ealingcommoner/RiverPollutionNetwork/README.md

# RiverPollutionNetwork
Building a low-cost community pollution detector for our local river

*Work in Progress*

## Background to project
The River Brent in West London is a little river which runs through a mix of urban industrial areas and the huge Brent River Park in Hanwell. 
The Brent River in Hanwell

Every few months we see pollution incidents from a range of causes:
- Deliberate dumping of pollutants
- Storm drains
- Badly connected outlets

These cause damage to the wildlife, particularly the many fish and eels which live in the River. 
We have formed a group which keeps an eye on the River and report pollution incidents so the Environment Agency can send a team to investigate and mitigate the damage. 

But we're a small group and it can take hours or days to notice a problem. Local authorities inform us that instaling an industrial monitoring station can be upwards of £6000 and are reluctant to do so on such a small river. So I wanted to know if a community can build something that will do the job for as little money as possible. 

## Aims
Use low-cost, remotely deployed sensors to alert the community to a pollution incident. 

## Measurement
Having reviewed pollution incident reports, it appears the most common indicators are:
- Total Dissolved Oxygen (TDO)
- Total Dissolved Solids (TDS)

TDO sensors are around £130 each, whilst [this TDS sensor](https://www.dfrobot.com/product-1662.html) is £11. We could consider adding TDO in future if funding permits, but for now it seems TDS gives us the best effect for our money.

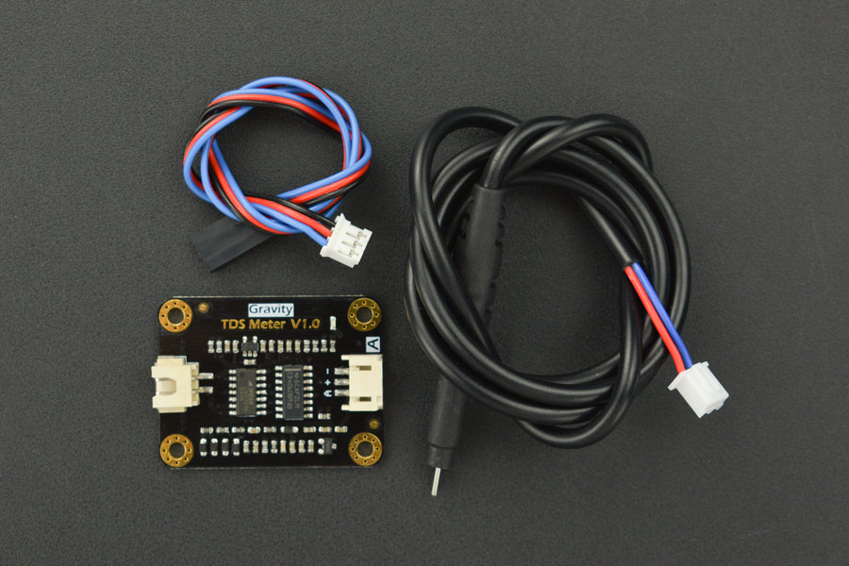
[picture p1: Gravity.jpg]
Gravity TDS Sensor


## Node
Each node will consist of
- 2 remote TDS sensors
- 1 remote temperature sensor (this is cruicial to calibrate our readings)
- 1 base station

Each remote station requires an ID. I have allocate 3 digit numbers in the system
- First digit: Node letter (9) for our first node
- Second digit: Type of sensor (9 for TDS, 8 for temperature)
- Third digit: Unique number. 
So our TDS sensors are 996 and 998 (it doesn't seem sensible to use '999' as an ID!) and temperature sensor is 986. All this code is configured on this system. 
This means we can add extra classes of devices (7 could be an oxygen sensor and 6 a relay for example). 

## The Brent Box

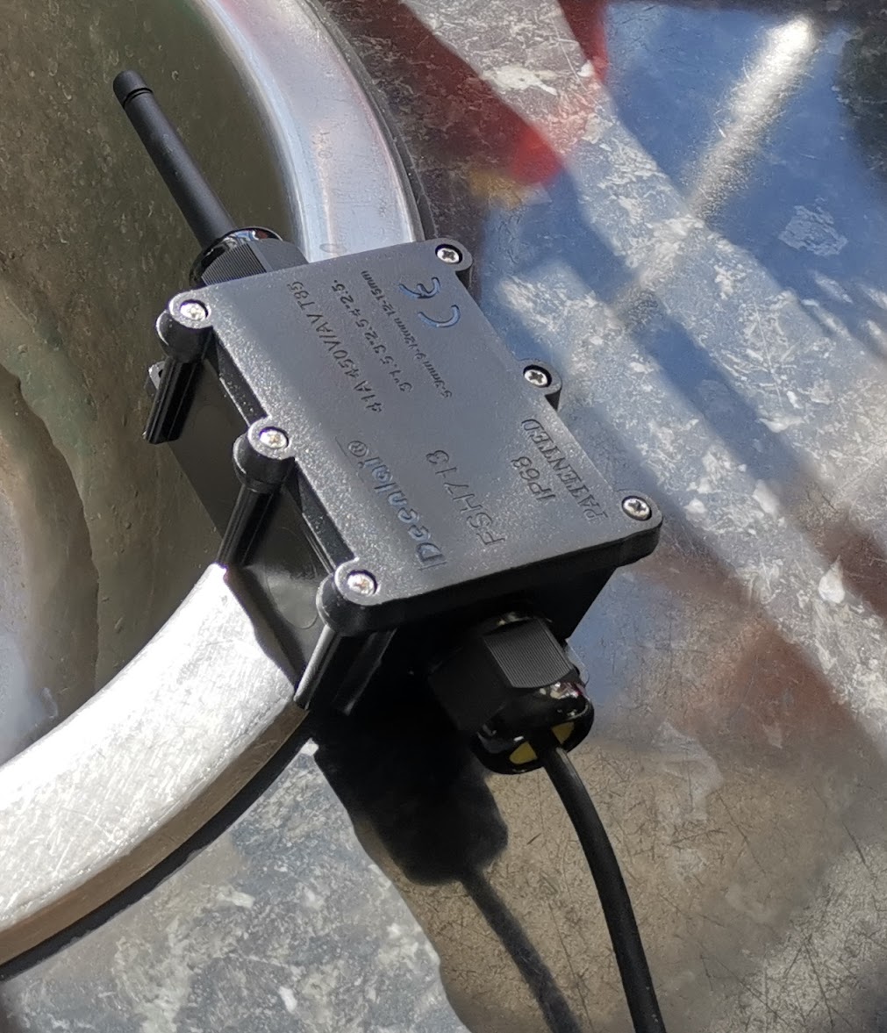
[picture p2: brentbox.jpg]
Brent Box


I wanted to build a system which was:
- Robust
- Resistant to the elements
- Built from cheap off the shelf parts. 
- Battery life of one month. 
- Can be adapted for any sensor. 

At the heart of the system is the Brent Box. We'll learn more about its construction as we build the TDS sensor. 

## Remote TDS Station

For the remote station I chose an [Adafruit Feather 32u4 with LoRa Radio Module](https://learn.adafruit.com/adafruit-feather-32u4-radio-with-lora-radio-module/setup) 
Radiofruit module

It has a low power usage and a built in LoRa radio for long range communications, along with a battery management circuit. Incredibly impressive for just £33. 

In addition we need a battery. I want a pretty powerful battery because ideally we want this to operate for weeks at a time without intervention. I'm avoiding solar panels if possible as they add cost. I went with the [6700mAh High Capacity Lithium Ion Battery](https://shop.pimoroni.com/products/high-capacity-lithium-ion-battery-pack?variant=32012684591187) for the prototype. 

### Assembly
Simply connect lithium battery and connect sensor to GND, 5V and A3 pin for analogue reader. You'll need to solder on:
- Header pins
- Whip antenna (cut wire to 8.2cm for 868MHZ frequency mode)
- Alternatively solder a UFT connector to add an antenna. 

Hey presto, one remote station
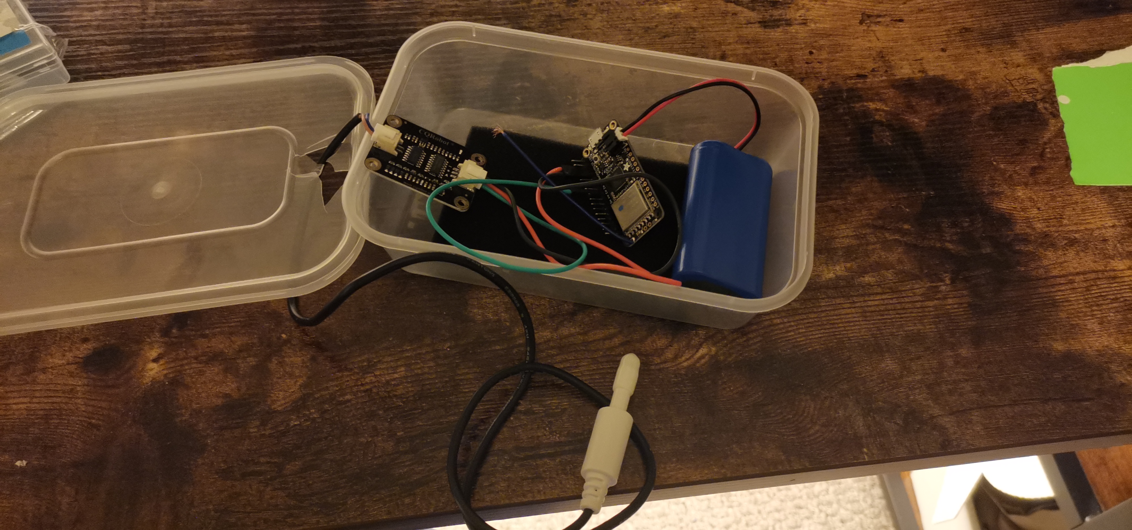
[picture p3: Prototype.jpg]
Remote station


### Casing
I recommend an IP68 Waterproof junction box like [this one](https://www.amazon.co.uk/dp/B09NFSTPGG/ref=cm_sw_em_r_mt_dp_WT0A1Q1RJGSB5GH1H0KC?_encoding=UTF8&psc=1)


This needs to be IP68 in the event of full immersion. 
Junction boxes are a cheap, tried and tested technology and discreet enough that our sensors should be fairly unnoticeable. 

### Cost
| Item | Cost |
| --- | --- |
| Adafruit Feather 32u4 with LoRa Radio Module | £33 |
| Gravity TDS Sensor | £11 |
| 6700mAh Lithium Batter | £18 |
| Junction box | £5 |
| **Total** | £67 |

This meets our requirements for a low cost sensor. An antenna adds £15 to the price.
I have tested the system and with an antenna sticking through the top space this appears to be waterproof. 

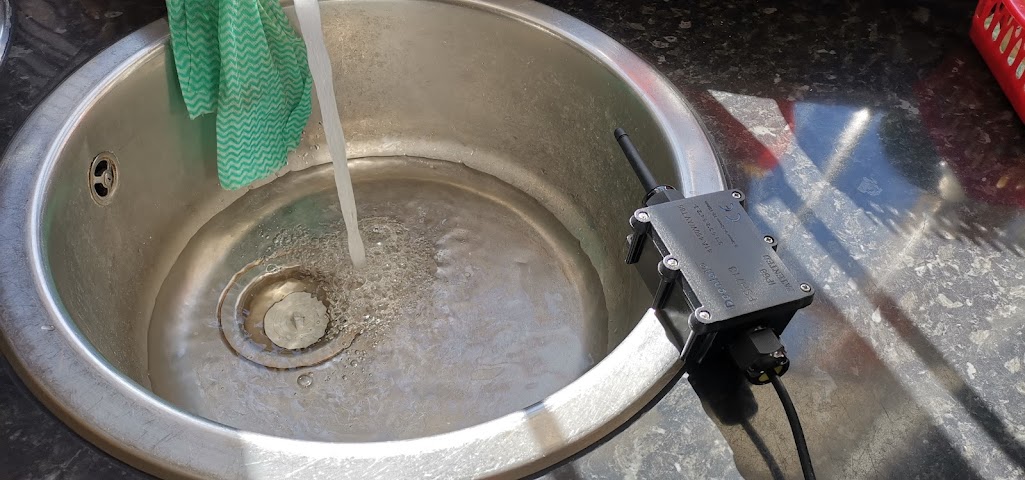
[picture p4: Sensor with aerial.jpg]
Finished prototype


## Code
Install Arduino IDE and ensure that you have the correct board and libraries added. You will need:
- Radiohead library
- Dallas Temperature
- Onewire
- Board is Adafruit Feather 32u4

Set your ID number to agree with the IDs you have included in your base station code and flash [this code](https://github.com/ealingcommoner/RiverPollutionNetwork/blob/main/tdsstation.ino). 
Note that this transmits every 15 minutes, you can alter this to reflect your needs (in the UK you require a 0.1% duty cycle, transmission time is <1s so this is compliant but a shorter duty cycle may not be)

## Temperature sensor
As above but using [Waterproof DS18B20-compatible Temperature Sensor](https://shop.pimoroni.com/products/ds18b20-programmable-resolution-1-wire-digital-thermometer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)

Again, set a suitable ID and flash [this code](https://github.com/ealingcommoner/RiverPollutionNetwork/blob/main/tempstation.ino). 

## Base station
I didn't like my original base station so have made a new one consisting of a Raspberry Pi Zero 2 and an  [Adafruit Lora Bonnet](https://shop.pimoroni.com/products/adafruit-lora-radio-bonnet-with-oled-rfm95w-915mhz-radiofruit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)

### Assembly

Even easier. Add Lora bonnet to pi, add an SD card for the operating system and plug in an antenna. 

## Bill of materials
| Item | Cost |
| --- | --- |
| Raspberry Pi Zero 2W  | £13.50 |
| Adafruit Lora Bonnet| £30.60 |
| 900 Mhz Antenna | £12.30 |
| **Total** | £56.70 |

I particularly like the little screen. As this will be headless we can make good use of that to see the most recent transmissions. 

Note: Make sure all Lora devices are RFM9x as different types of devices cannot communicate. This limits our frequency to around 900Mhz. 

Important: You must make sure that you follow radio frequency laws in your area. In the UK devices must use 863-870Mhz or 433Mhz.

I have used the maximum transmission power allowed (23dB) and the transmission mode Bw125Cr45Sf128. Feel free to change but it is a rabbit hole and I would not recommend revisiting again!

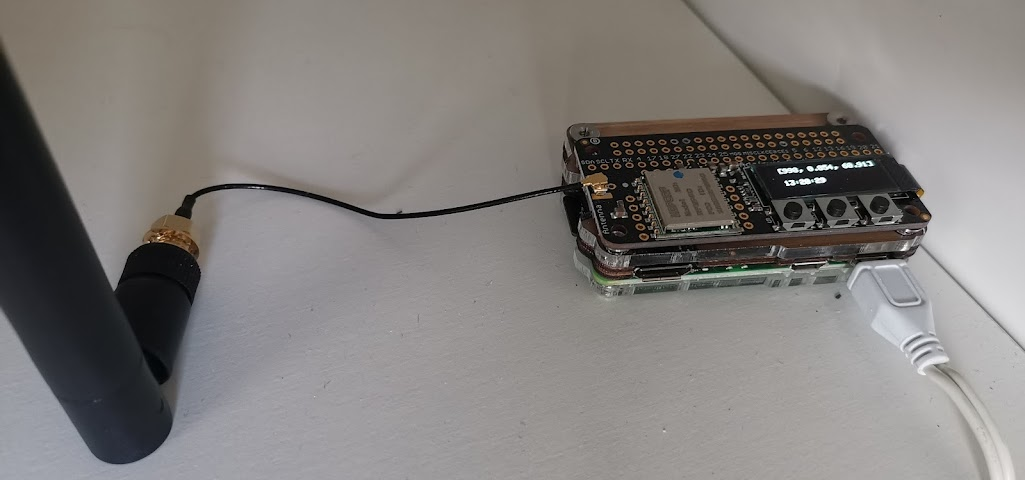
[picture p5: Base station zero.jpg]
Final base station


## Base station code

Set up raspberry Pi as usual. Install libraries from [here](https://learn.adafruit.com/adafruit-radio-bonnets)
[Base station code](https://github.com/ealingcommoner/RiverPollutionNetwork/blob/main/brentbase_pub.py)
Our code is quite complex but uses the ID of each station to put together a payload to send to thingspeak.com. 

Recorded data includes:
- Probe readings (TDS and temperature)
- Battery readings
- Signal strength
You should set up a channel at thingspeak and enter your channel number and API key. 
I know it is best practice to have one channel per device but as I'm planning several nodes I'm considering the ensure node to be one device. 

## Thingspeak
As the base station code stands it will fill the fields in this order, so you should name your fields in the same way. 
- TDS Unit 996 (units PPM)
- Battery Unit 996 (As a percentage counting down to 3.3V)
- TDS Unit 998
- Battery Unit 998
- Signal Strength 996 (dB)
- Signal Strength 998
- Temperature Unit 986 (Centrigrade)
- Battery Unit 986. 

## Calibration
I have run this in a sealed container with tap water for 12 hours and compared average readings with known readings from a handheld meter. This lets me calculate K values for our code. (I found out the hard way that an unsealed container suffers from evaporation, which means your TDS readings will climb as the water becomes more concentrated). 

Note that readings take time to settle down. The temperature sensor needs a while to settle in and so for the first hour or so readings are quite unstable. 

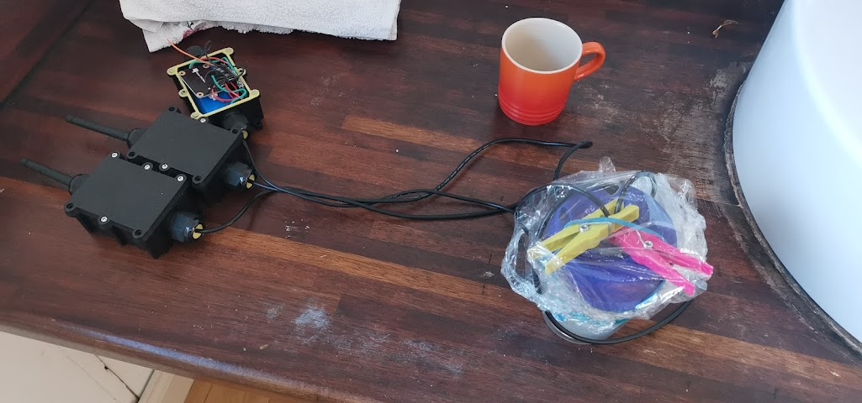
[picture p6: calibration.jpg]
calibration test


After calibration we are finding that readings are in agreement to within 2ppm and there's a variation of less than 1ppm over time. I would estimate error as 0.6%. From reading reports of pollution images we need to be able to detect changes of ~10% so I'm feeling confident. 

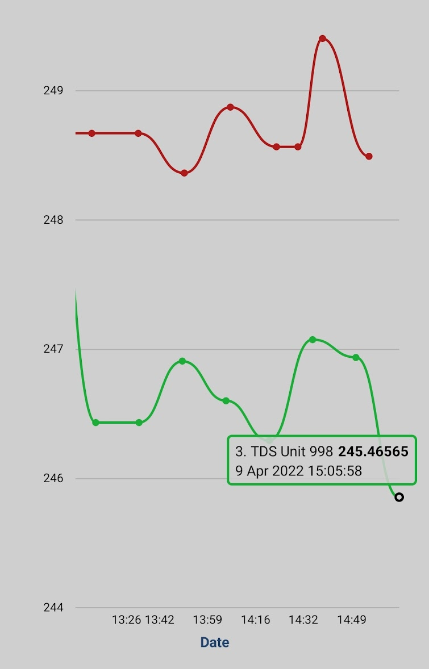
[picture p7: tapwatertesting.jpg]
Readings over time post calibration


## Battery life
I'm predicting a battery life of around 30 days, you can use a simple linear model like [this](https://github.com/ealingcommoner/RiverPollutionNetwork/blob/main/batterymodel.R) to predict battery life.

## Range
In testing I have found a range of 350m, your experience may vary based on buildings and trees in the range and aerial placement. 

## To do next
- Test sensors with a range of materials including mineral water and distilled water. 
- Tweak power settings. I had experimented with taking 25 readings over a minute, this offers no benefit over a single reading, therefore I am testing 5 readings with a delay of 100ms making live time half a second. I'm also dialling duty cycle down to 30 minutes to boost battery life. 
- Deploy to river. Ideally these will just be attached to a stake and hammered in. 

You could build a cluster model with a range of sensors (TDO, TDS and temperature) for the best possible range of readings. 
To cover more river I have a few ideas, either getting local volunteers to host their own base stations and/or or some simple relay stations based around the Brent Box design. A relay design has obvious weak points as losing a single relay cuts off everything downrange. My preferance would be to combine relays and base stations along the route for a more resilient network design.

## Brent Box 2
Our plan is to deploy the sensors for a month and see if we get useful data. The only way to replenish the batteries will be to get in the river and physically open the boxes to replace, which will get tiresome very fast. A future version of the network will need to be solar powered so we can just place and forget. I'm looking at the Adafruit solar charging system and a slightly larger box to do this. If power (and coding skills permit) I'd like each Mk2 to have temperature and TDS and act as a relay. 

## Notes on project
- This is my first microcontroller project and I'm extremely grateful to the Radiohead library creators for making this easy. 
- If you think this is something that can help your community please do it. Feel free to use, criticise or modify anything I've created to make it happen but please give credit where appropriate. If you want to build your own maybe wait until I've finished the first test and see if any unexpected bugs emerge.  
- Massive thanks to the incredible service from The Pi Hut and Pimoroni. As ever I'm staggered by the sheer creativity of Adafruit and their incredible board.
