ealingcommoner/RiverPollutionNetwork/Base station.jpg

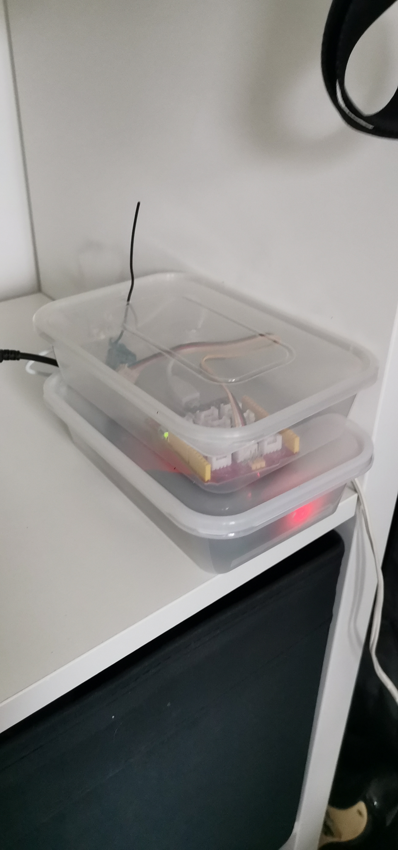
Base station.jpg
