ealingcommoner/RiverPollutionNetwork/Remote station housing.jpg

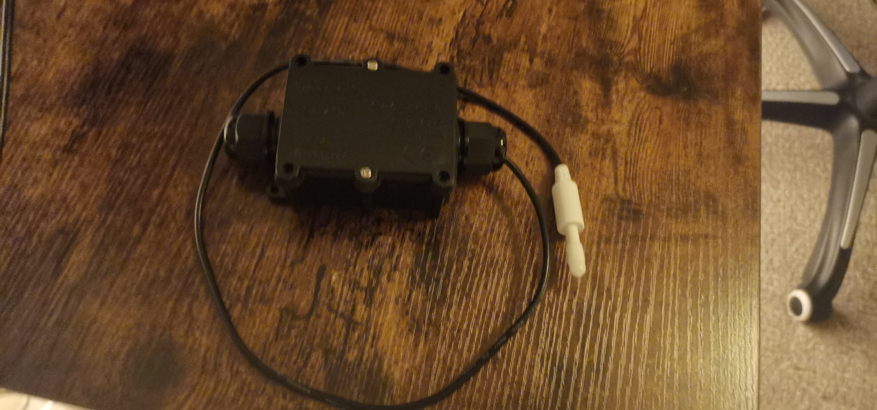
Remote station housing.jpg
