ealingcommoner/RiverPollutionNetwork/signaltester.png

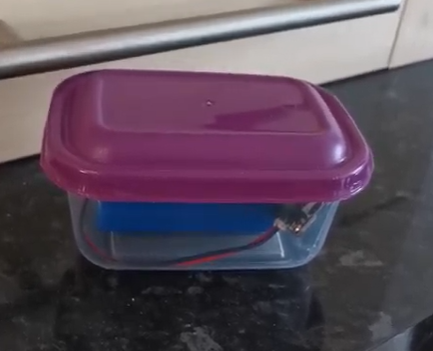
signaltester.png
