ealingcommoner/RiverPollutionNetwork/Viaduct.jpg

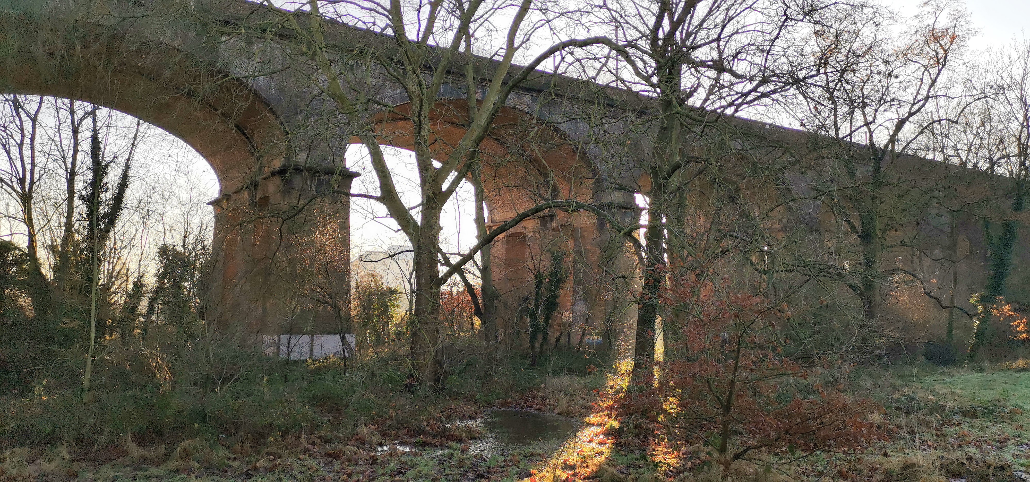
Viaduct.jpg
